elkel53930/ExICE-M/ExICE-M.PNG

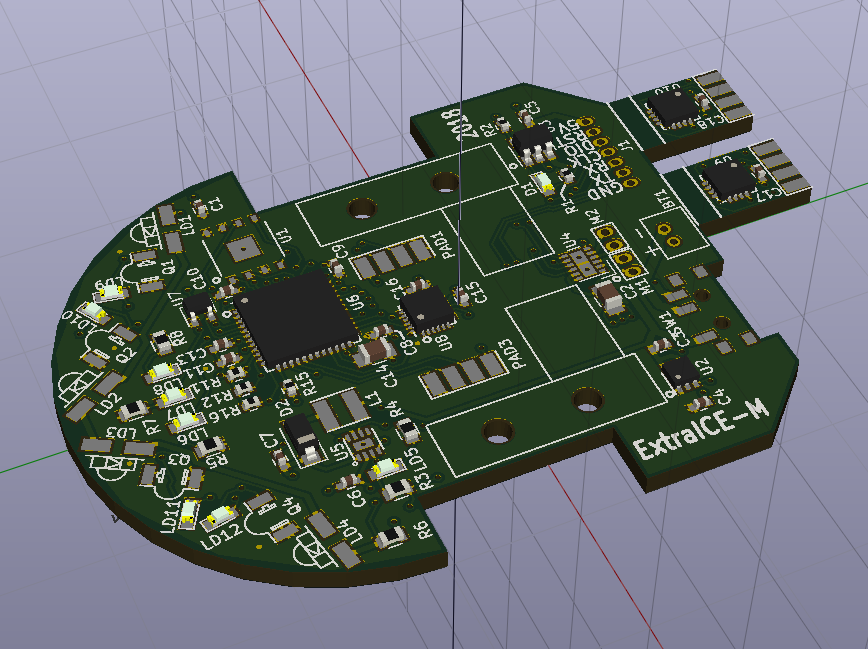
ExICE-M.PNG
