elkel53930/ExICE-M/KiCad/bom-ExICE-Mf_for_pcbgogo.xlsx

品名 Name | 部品番号 Designator | 個数 Quantity | 値 Value | パッケージ Package | 説明 Description | 部品メーカー Manufacturer | 部品メーカーの品番 Manufacturer Part Number | 代替可否
Connector | BT1 | 1 |  | Through Hole |  | JST | B2B-ZR | 代替不可
Ceramic Capacitor | C1 C10 C11 C13 C15 C16 C17 C18 C7 C8 C9 | 11 | 0.22uF X5R 50V | 1005 | metric |  |  | B,X7R,X8R特性でも可
Ceramic Capacitor | C14 C2 | 2 | 10uF X5R 10V | 2012 | metric |  |  | B,X7R,X8R特性でも可
Ceramic Capacitor | C3 C4 C5 C6 | 4 | 2.2uF X5R 10V | 1005 | metric |  |  | B,X7R,X8R特性でも可
LED | D1 LD10 LD11 LD12 LD5 LD8 LD9 | 7 |  | 1608 | metric | Stanley Electronic | BR1111C | Stanley, FR1111C
Diode | D2 | 1 |  | SOD-123 |  | Diodes | B0520LW-7-F | Taiwan Semiconductor, B0520LWF RHG
Inductor | L1 | 1 |  | 3mm x 3mm SMD |  | Bourns | SRN3015-100M | 代替不可
LED | LD1 LD2 LD3 LD4 | 4 |  | Right Angle SMD |  | Kingbright | APDA3020SECK/J3-PF | 代替不可
LED | LD6 | 1 |  | 1608 | metric | Stanley Electronic | BG1111C | 視野角100度以上、1608サイズ、緑色LEDで代替可
LED | LD7 | 1 |  | 1608 | metric | Stanley Electronic | AY1111C | 視野角100度以上、1608サイズ、黄色LEDで代替可
Register | R1 R11 R12 R15 R16 | 5 | 1KΩ 1% | 1005 | metric |  |  | 誤差1%未満でも可
Register | R2 | 1 | 10KΩ 5% | 1005 | metric |  |  | 誤差5%未満でも可
Register | R3 | 1 | 10KΩ 5% | 1608 | metric |  |  | 誤差5%未満でも可
Register | R4 R5 R7 R8 | 4 | 220Ω 5% | 1608 | metric |  |  | 誤差5%未満でも可
Register | R6 | 1 | 1Ω 1% | 1608 | metric |  |  | 誤差1%未満でも可
Switch | SW1 | 1 |  |  |  | Nidec Copal | CUS-12TB | 代替不可
MRAM | U1 | 1 |  | 8-DFN Small Flag |  | Everspin | MR25H40CDF | 代替不可
Voltage regulator | U2 | 1 |  | 2mm x 2mm WDFN6 |  | On Semiconductor | NCV8705MT30TCG | 代替不可
Battery charge controller | U3 | 1 |  | ThinSOT23-5 |  | Linear Technology | LTC4054ES5-4.2 | 代替不可
Motor driver | U4 | 1 |  | WSON8 |  | Texas Instruments | DRV8836DSSR | 代替不可
LED driver | U5 | 1 |  | 8-MLF |  | Microchip Technology | MIC2291-15YML | 代替不可
MCU | U6 | 1 |  | 7mm x 7mm UFQFPN48 |  | STMicroelectronics | STM32F411CEU6 | 代替不可
Oscillator | U7 | 1 |  | SC70-3 |  | Maxim | MAX7375AXR805+T | 代替不可
IMU sensor | U8 | 1 |  | 3mm x 3mm QFN24 |  | TDK InvenSense | ICM-20648 | 代替不可
Encoder | U9 U10 | 2 |  | 3mm x 3mm QFN16 |  | Monolithic Power Systems | MA700 | 代替不可
Other devices (not mount) | J1 R10 R13 R14 R9 PAD1 PAD2 PAD3 PAD4 M1 M2 Q1 Q2 Q3 Q4 | - | - | - | - | - | - | not mount
