elkel53930/ExICE-M/KiCad/Schematic.pdf

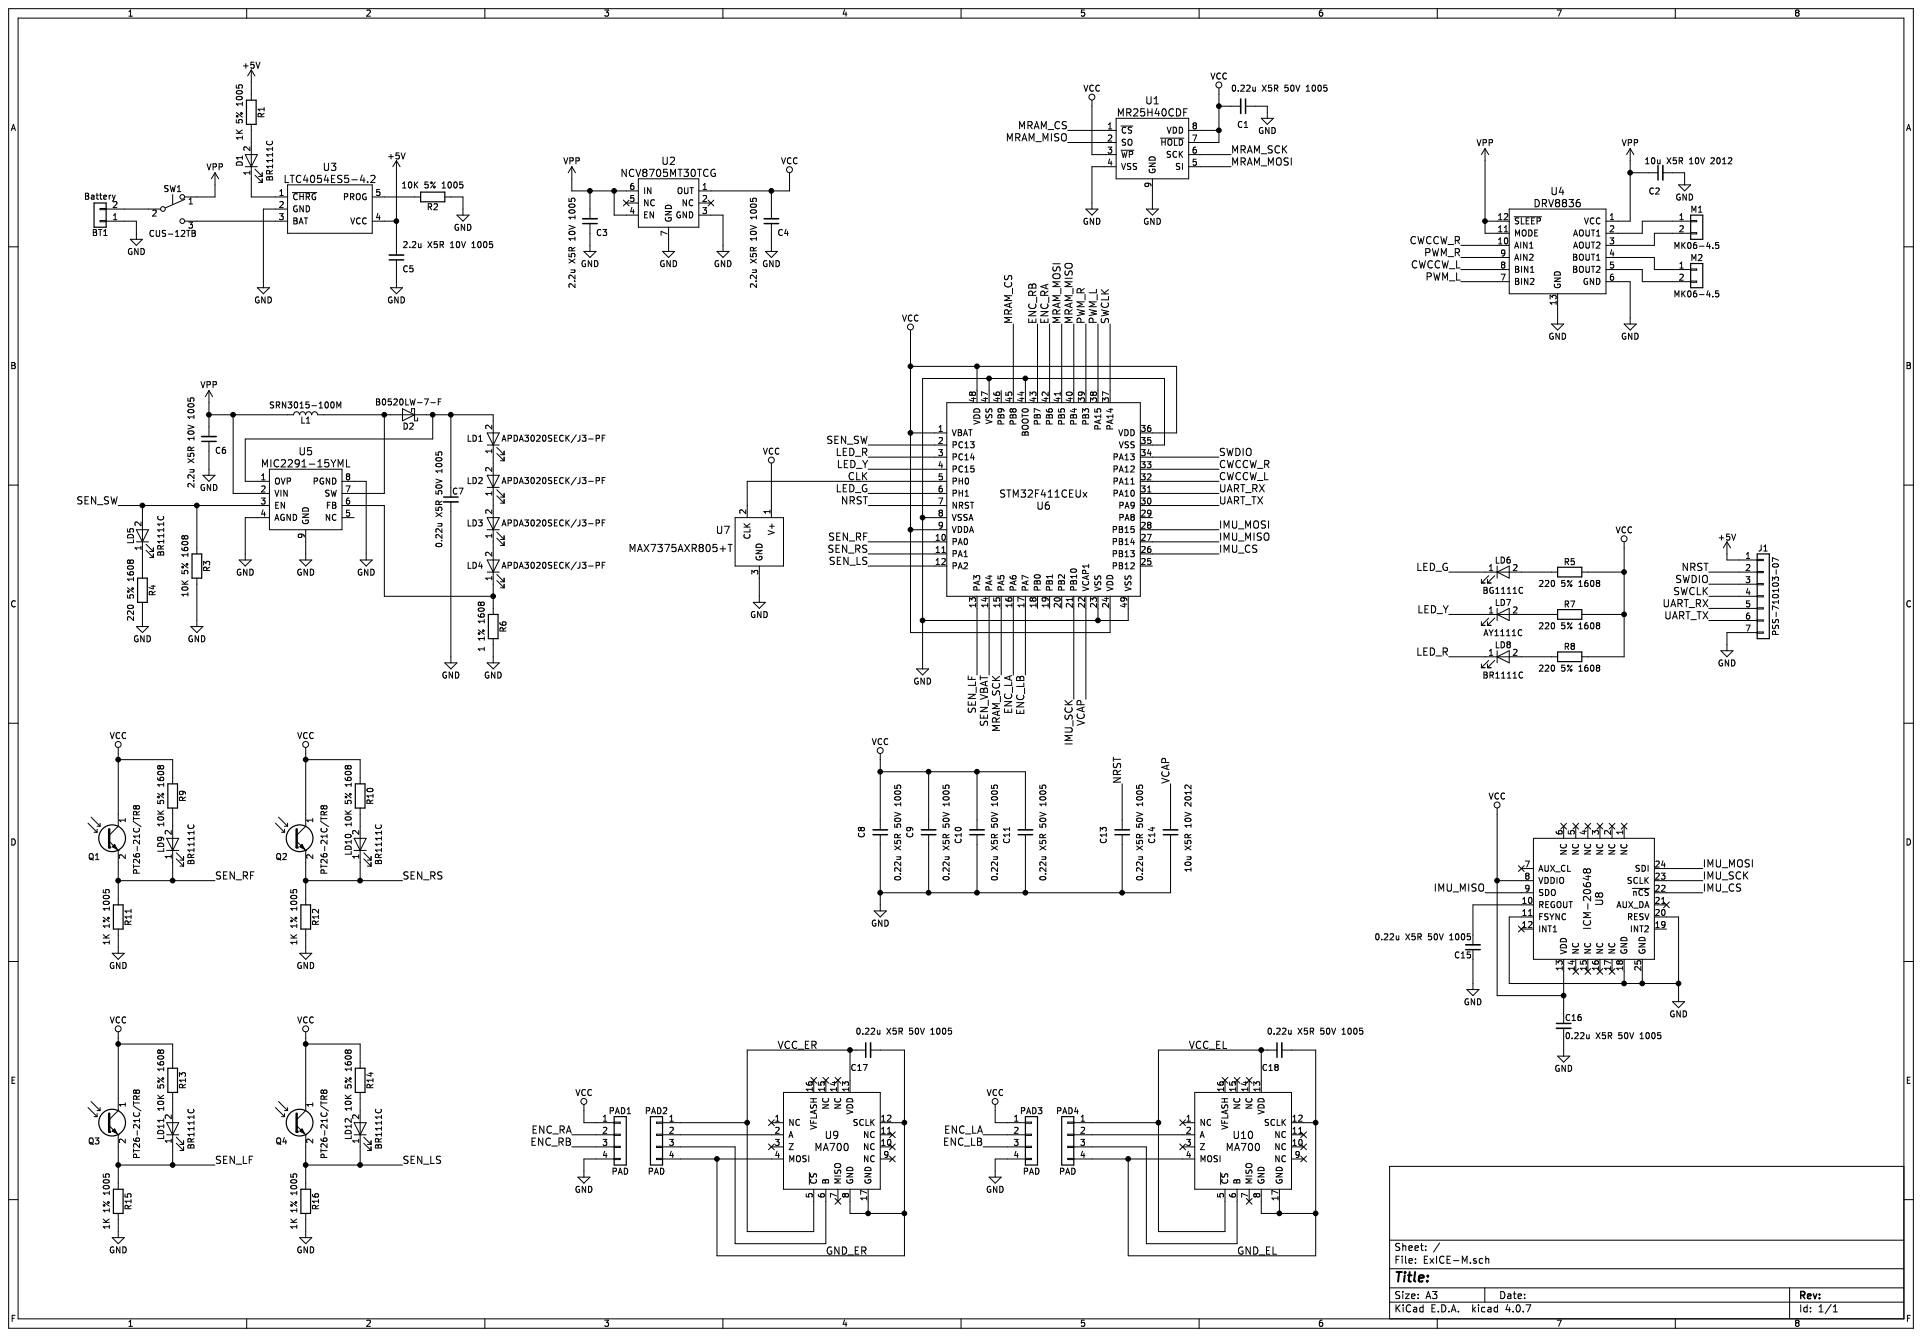
[picture p2: page 1]
