elkel53930/ExICE-M/KiCad/ExICE-M.kicad_pcb

## KiCad design KiCad/ExICE-M.kicad_pcb (2018-11-22)

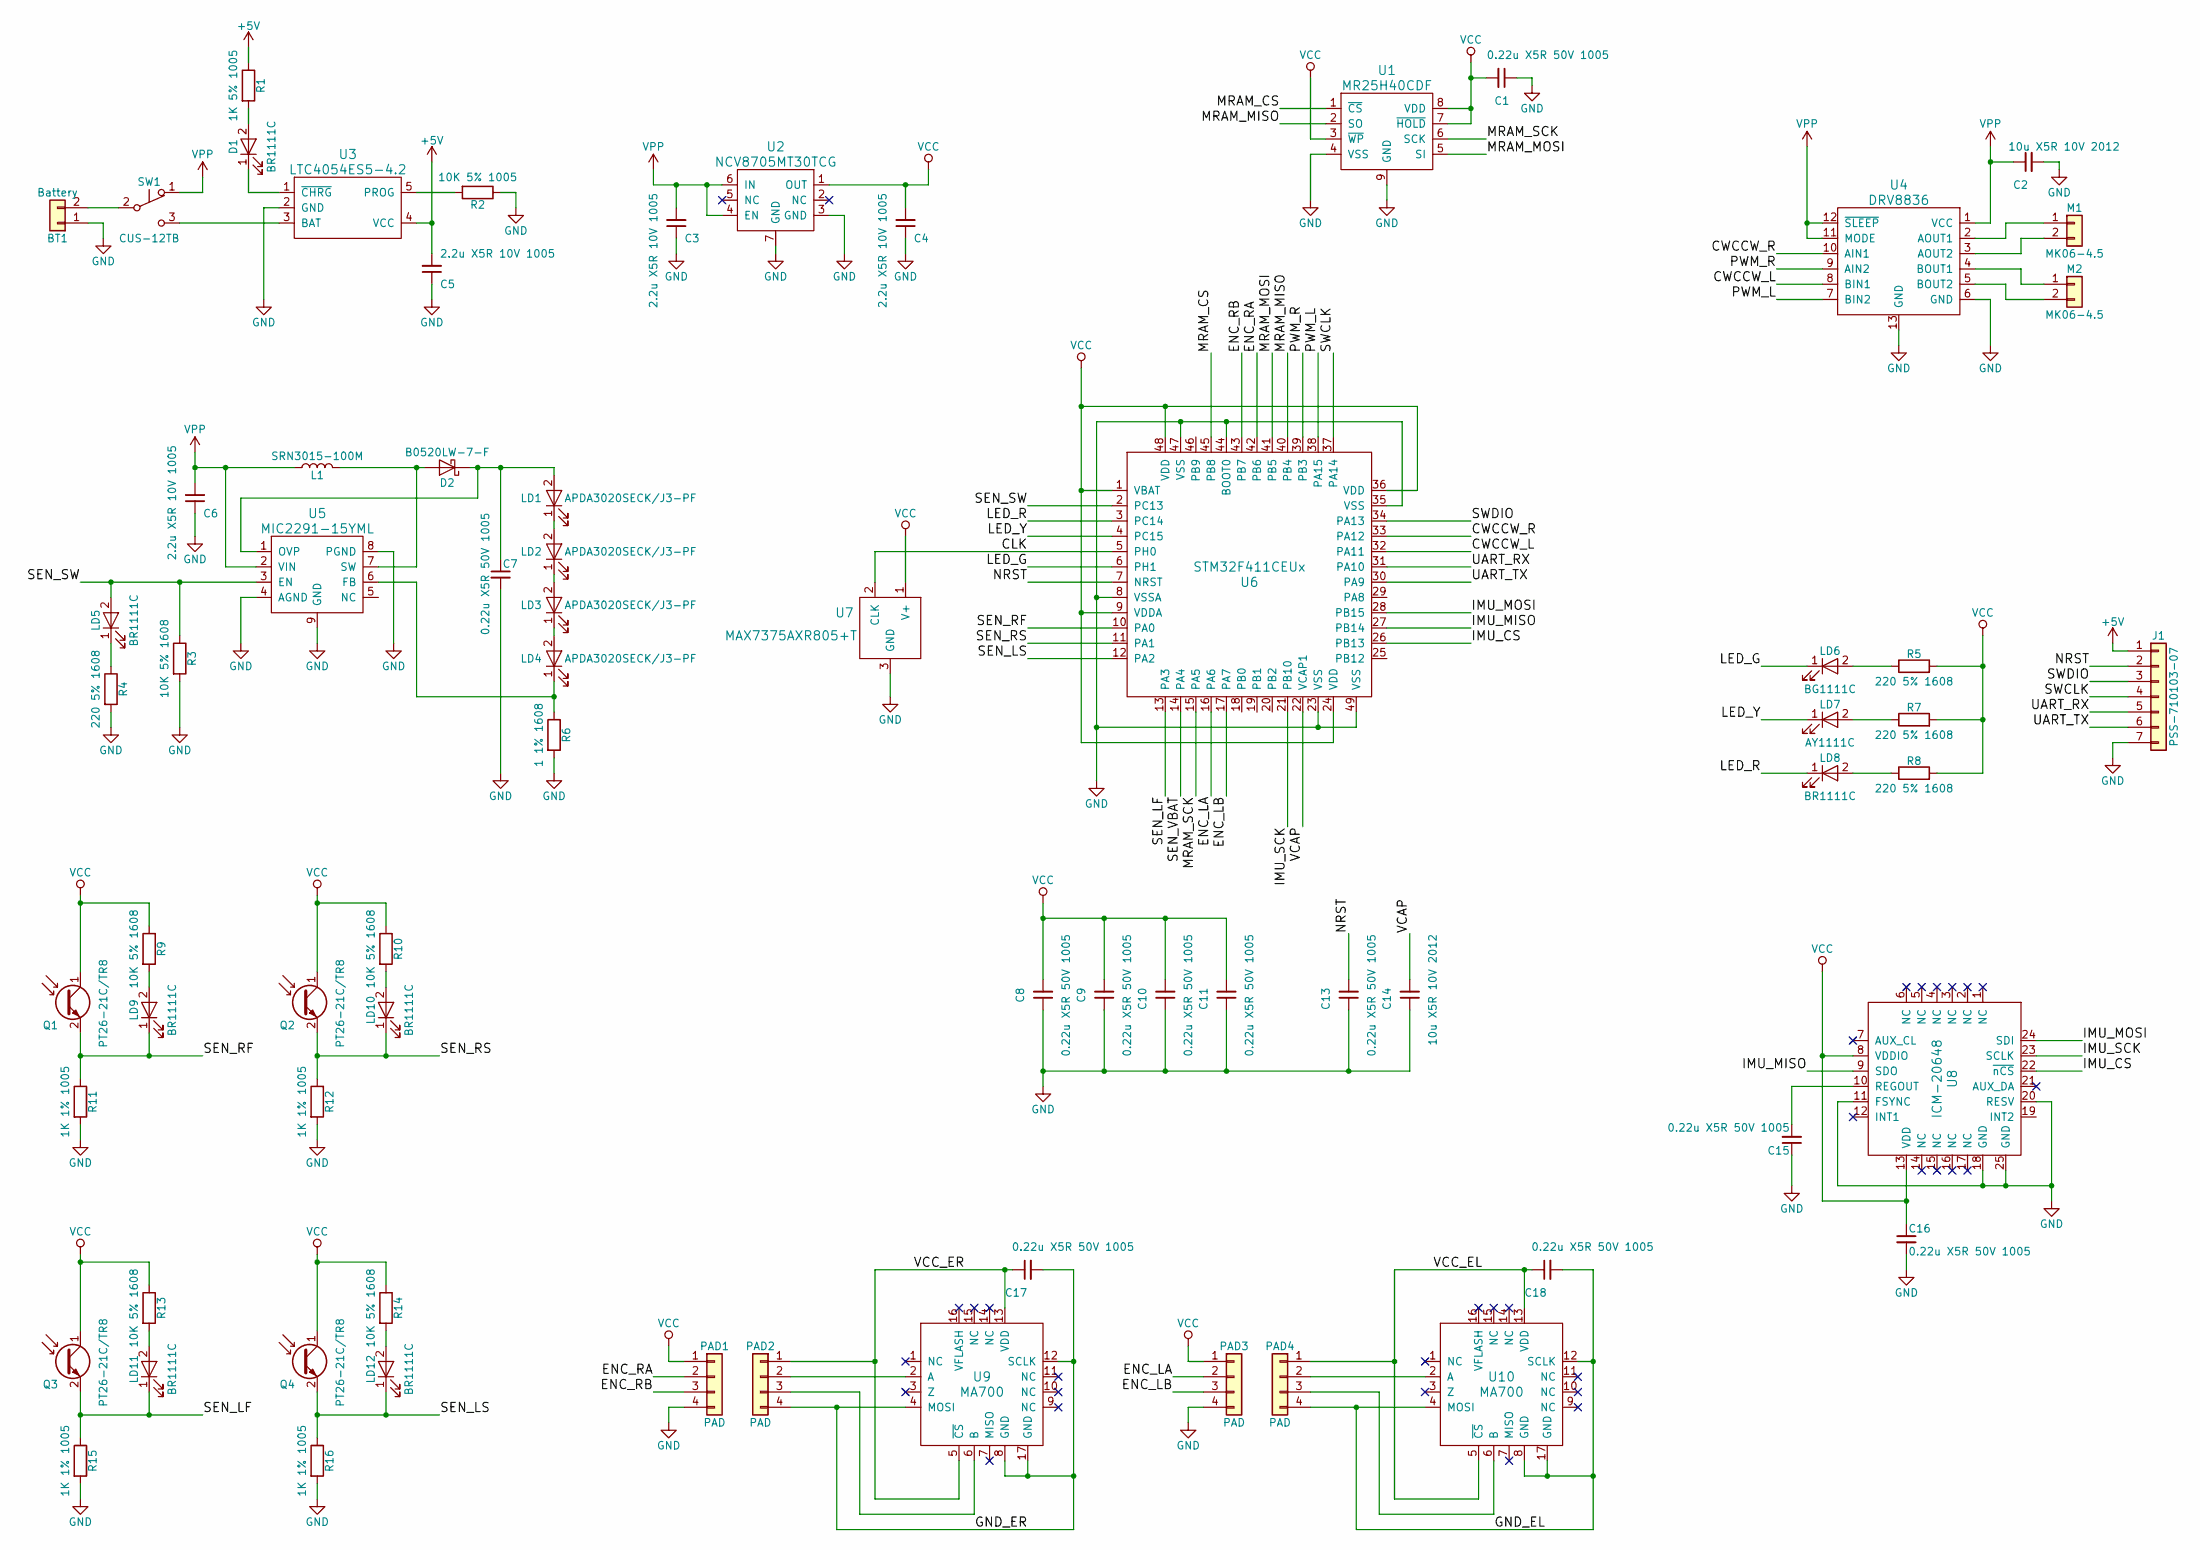
[picture p3: schematic ExICE-M.sch]

Parts:
BT1: Battery; B2B-ZR
C1, C7, C8, C9, C10, C11, C13, C15, C16, C17, C18: 0.22u X5R 50V 1005; C_0402
C2, C14: 10u X5R 10V 2012; C_0805
C3, C4, C5, C6: 2.2u X5R 10V 1005; C_0402
D1: BR1111C; LED_0603
D2: B0520LW-7-F; D_SOD-123
J1: PSS-710103-07; 1.27mm_PinHeader_7pole
L1: SRN3015-100M; SRN3015
LD1, LD2, LD3, LD4: APDA3020SECK/J3-PF; APDA3020SECK_J3-PF
LD5, LD8, LD9, LD10, LD11, LD12: BR1111C; LED_0603
LD6: BG1111C; LED_0603
LD7: AY1111C; LED_0603
M1, M2: MK06-4.5
PAD1: PAD; MOTOR_ASSY_R
PAD2, PAD4: PAD; PAD_MAIN-ENC
PAD3: PAD; MOTOR_ASSY_L
Q1, Q2, Q3, Q4: PT26-21C/TR8; PT26-21C_TR8_Right
R1: 1K 5% 1005; R_0402
R2: 10K 5% 1005; R_0402
R3, R9, R10, R13, R14: 10K 5% 1608; R_0603
R4, R5, R7, R8: 220 5% 1608; R_0603
R6: 1 1% 1608; R_0603
R11, R12, R15, R16: 1K 1% 1005; R_0402
SW1: CUS-12TB
U1: MR25H40CDF; DFN8_Small_Flag
U2: NCV8705MT30TCG; DFN-6-1EP_2x2mm_Pitch0.65mm
U3: LTC4054ES5-4.2; SOT-23-5
U4: DRV8836; WSON-12-1EP_3x2mm_Pitch0.5mm
U5: MIC2291-15YML; 8PinMLF
U6: STM32F411CEUx; QFN-48-1EP_7x7mm_Pitch0.5mm
U7: MAX7375AXR805+T; SOT-323_SC-70
U8: ICM-20648; QFN-24-1EP_3x3mm_Pitch0.4mm
U9, U10: MA700; QFN-16-1EP_3x3mm_Pitch0.5mm

Connections:
+5V: C5.2, J1.1, R1.1, U3.4 (VCC)
/CLK: U6.5 (PH0), U7.2 (CLK)
/CWCCW_L: U4.8 (BIN1), U6.32 (PA11)
/CWCCW_R: U4.10 (AIN1), U6.33 (PA12)
/ENC_LA: PAD3.2, U6.16 (PA6)
/ENC_LB: PAD3.3, U6.17 (PA7)
/ENC_RA: PAD1.2, U6.42 (PB6)
/ENC_RB: PAD1.3, U6.43 (PB7)
/GND_EL: C18.2, PAD4.4, U10.4 (MOSI), U10.8 (GND), U10.12 (SCLK), U10.17 (GND)
/GND_ER: C17.2, PAD2.4, U9.4 (MOSI), U9.8 (GND), U9.12 (SCLK), U9.17 (GND)
/IMU_CS: U6.26 (PB13), U8.22 (~nCS)
/IMU_MISO: U6.27 (PB14), U8.9 (SDO)
/IMU_MOSI: U6.28 (PB15), U8.24 (SDI)
/IMU_SCK: U6.21 (PB10), U8.23 (SCLK)
/LED_G: LD6.1 (K), U6.6 (PH1)
/LED_R: LD8.1 (K), U6.3 (PC14)
/LED_Y: LD7.1 (K), U6.4 (PC15)
/MRAM_CS: U1.1 (~CS), U6.45 (PB8)
/MRAM_MISO: U1.2 (SO), U6.40 (PB4)
/MRAM_MOSI: U1.5 (SI), U6.41 (PB5)
/MRAM_SCK: U1.6 (SCK), U6.15 (PA5)
/NRST: C13.2, J1.2, U6.7 (NRST)
/PWM_L: U4.7 (BIN2), U6.38 (PA15)
/PWM_R: U4.9 (AIN2), U6.39 (PB3)
/SEN_LF: LD11.1 (K), Q3.2 (E), R15.1, U6.13 (PA3)
/SEN_LS: LD12.1 (K), Q4.2 (E), R16.1, U6.12 (PA2)
/SEN_RF: LD9.1 (K), Q1.2 (E), R11.1, U6.10 (PA0)
/SEN_RS: LD10.1 (K), Q2.2 (E), R12.1, U6.11 (PA1)
/SEN_SW: LD5.2 (A), R3.1, U5.3 (EN), U6.2 (PC13)
/SWCLK: J1.4, U6.37 (PA14)
/SWDIO: J1.3, U6.34 (PA13)
/UART_RX: J1.5, U6.31 (PA10)
/UART_TX: J1.6, U6.30 (PA9)
/VCAP: C14.2, U6.22 (VCAP1)
/VCC_EL: C18.1, PAD4.1, U10.5 (~CS), U10.13 (VDD)
/VCC_ER: C17.1, PAD2.1, U9.5 (~CS), U9.13 (VDD)
GND: BT1.1, C1.1, C2.2, C3.1, C4.1, C5.1, C6.1, C7.2, C8.1, C9.1, C10.1, C11.1, C13.1, C14.1, C15.1, C16.2, J1.7, PAD1.4, PAD3.4, R2.1, R3.2, R4.2, R6.2, R11.2, R12.2, R15.2, R16.2, U1.4 (VSS), U1.9 (GND), U2.3 (GND), U2.7 (GND), U3.2 (GND), U4.6 (GND), U4.13 (GND), U5.4 (AGND), U5.8 (PGND), U5.9 (GND), U6.8 (VSSA), U6.23 (VSS), U6.35 (VSS), U6.44 (BOOT0), U6.47 (VSS), U6.49 (VSS), U7.3 (GND), U8.11 (FSYNC), U8.18 (GND), U8.20 (RESV), U8.25 (GND)
unnamed: BT1.2, SW1.2 (B)
unnamed: C7.1, D2.1 (K), LD1.2 (A), U5.1 (OVP)
unnamed: C15.2, U8.10 (REGOUT)
unnamed: D1.1 (K), U3.1 (~CHRG)
unnamed: D1.2 (A), R1.2
unnamed: D2.2 (A), L1.2, U5.7 (SW)
unnamed: LD1.1 (K), LD2.2 (A)
unnamed: LD2.1 (K), LD3.2 (A)
unnamed: LD3.1 (K), LD4.2 (A)
unnamed: LD4.1 (K), R6.1, U5.6 (FB)
unnamed: LD5.1 (K), R4.1
unnamed: LD6.2 (A), R5.1
unnamed: LD7.2 (A), R7.1
unnamed: LD8.2 (A), R8.1
unnamed: LD9.2 (A), R9.2
unnamed: LD10.2 (A), R10.2
unnamed: LD11.2 (A), R13.2
unnamed: LD12.2 (A), R14.2
unnamed: M1.1, U4.2 (AOUT1)
unnamed: M1.2, U4.3 (AOUT2)
unnamed: M2.1, U4.4 (BOUT1)
unnamed: M2.2, U4.5 (BOUT2)
unnamed: PAD2.2, U9.2 (A)
unnamed: PAD2.3, U9.6 (B)
unnamed: PAD4.2, U10.2 (A)
unnamed: PAD4.3, U10.6 (B)
unnamed: R2.2, U3.5 (PROG)
unnamed: SW1.3 (C), U3.3 (BAT)
VCC: C1.2, C4.2, C8.2, C9.2, C10.2, C11.2, C16.1, PAD1.1, PAD3.1, Q1.1 (C), Q2.1 (C), Q3.1 (C), Q4.1 (C), R5.2, R7.2, R8.2, R9.1, R10.1, R13.1, R14.1, U1.3 (~WP), U1.7 (~HOLD), U1.8 (VDD), U2.1 (OUT), U6.1 (VBAT), U6.9 (VDDA), U6.24 (VDD), U6.36 (VDD), U6.48 (VDD), U7.1 (V+), U8.8 (VDDIO), U8.13 (VDD)
VPP: C2.1, C3.2, C6.2, L1.1, SW1.1 (A), U2.4 (EN), U2.6 (IN), U4.1 (VCC), U4.11 (MODE), U4.12 (~SLEEP), U5.2 (VIN)

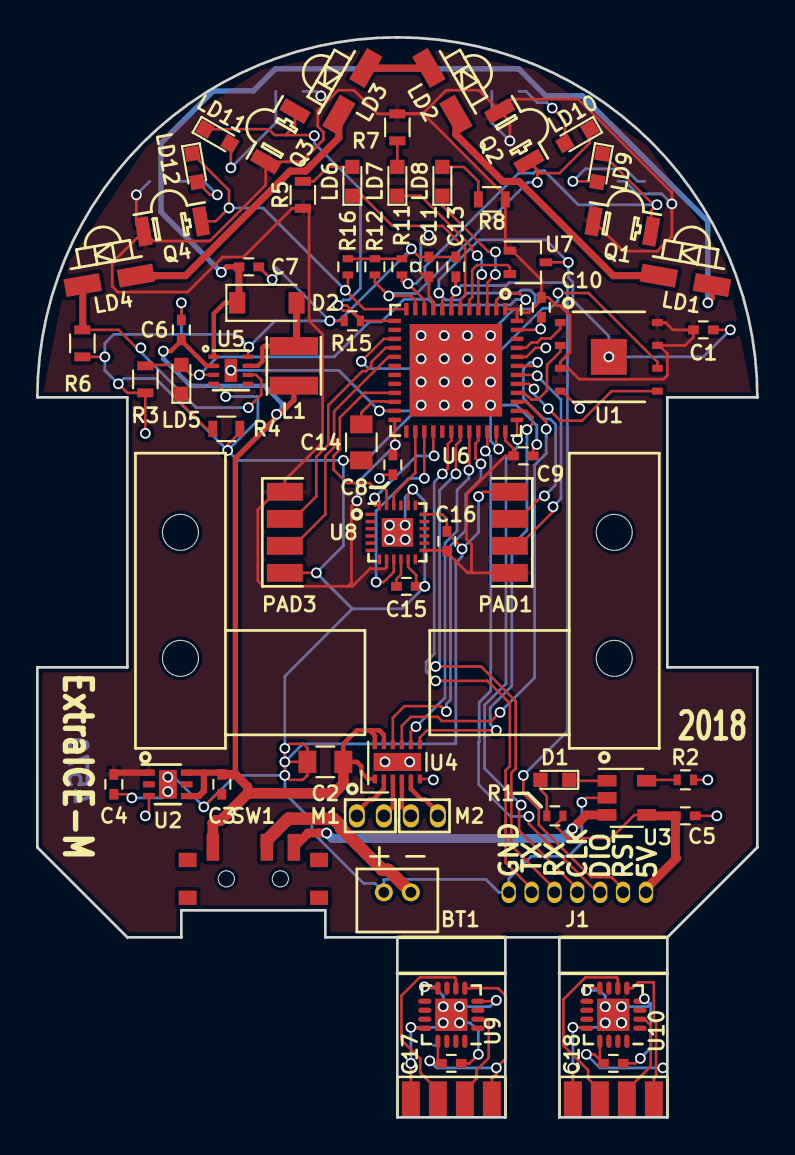
[picture p4: board ExICE-M.kicad_pcb from above]

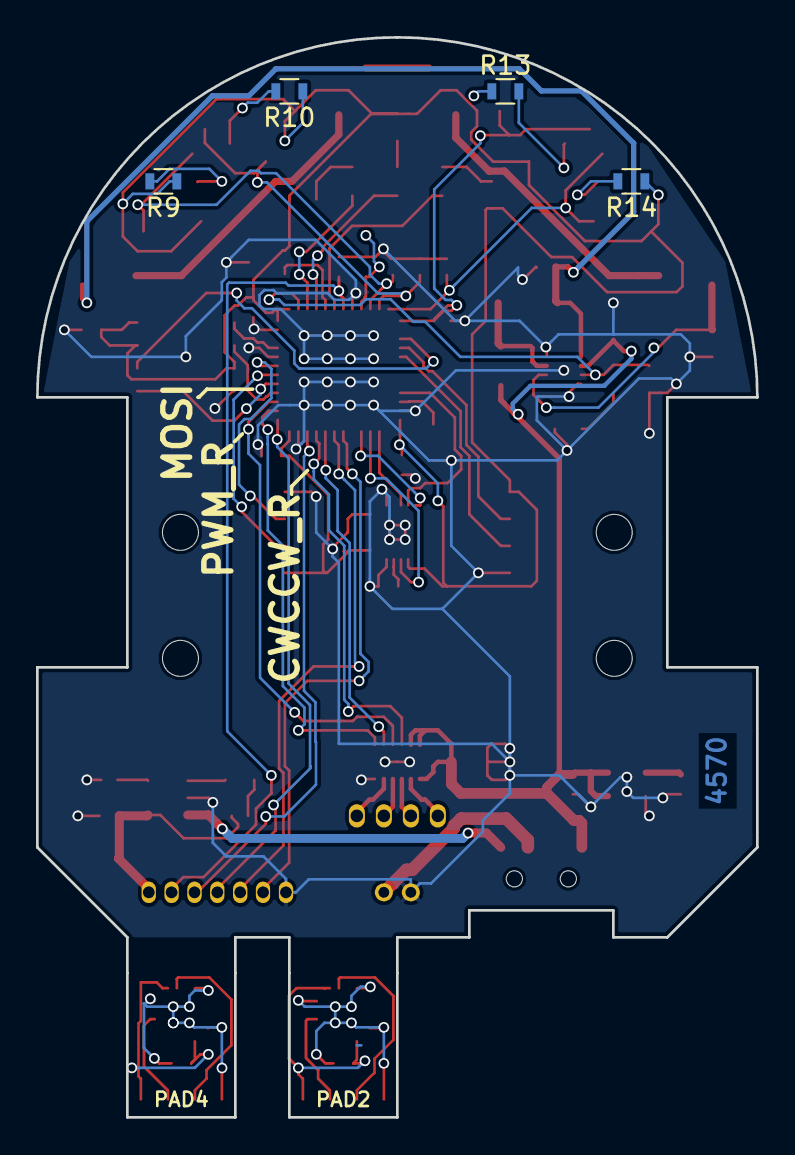
[picture p5: board ExICE-M.kicad_pcb from below]

Board: 2 copper layers, 40.0 x 60.0 mm, 71 parts (4 on the bottom side), 67 nets.
