elkel53930/ExICE-M/CubeMX/ExICE-M.ioc

Mcu.UserName=STM32F411CEUx
PA0-WKUP.Signal=ADCx_IN0
PA1.Signal=ADCx_IN1
PA10.Signal=USART1_RX
PA13.Signal=SYS_JTMS-SWDIO
PA14.Signal=SYS_JTCK-SWCLK
PA15.Signal=S_TIM2_CH1_ETR
PA2.Signal=ADCx_IN2
PA3.Signal=ADCx_IN3
PA4.Signal=ADCx_IN4
PA5.Signal=SPI1_SCK
PA6.Signal=S_TIM3_CH1
PA7.Signal=S_TIM3_CH2
PA9.Signal=USART1_TX
PB10.Signal=SPI2_SCK
PB14.Signal=SPI2_MISO
PB15.Signal=SPI2_MOSI
PB3.Signal=S_TIM2_CH2
PB4.Signal=SPI1_MISO
PB5.Signal=SPI1_MOSI
PB6.Signal=S_TIM4_CH1
PB7.Signal=S_TIM4_CH2
