elkel53930/ExICE-M/(commit log)

2018-11-25 Add schematic(PDF).
2019-12-02 KiCadバージョンアップ
    [ExICE-M.sch]
